acanyulaf/4SW-1KW-Buck-Boost/README.md

# 4SW-1KW-Buck-Boost
 1kW 28V 4 Switches Buck Boost Converter with 28V Fixed Output, Voltage Ripple<1% Inductor Current Ripple<30%
