acanyulaf/4SW-1KW-Buck-Boost/plots/frequency.png

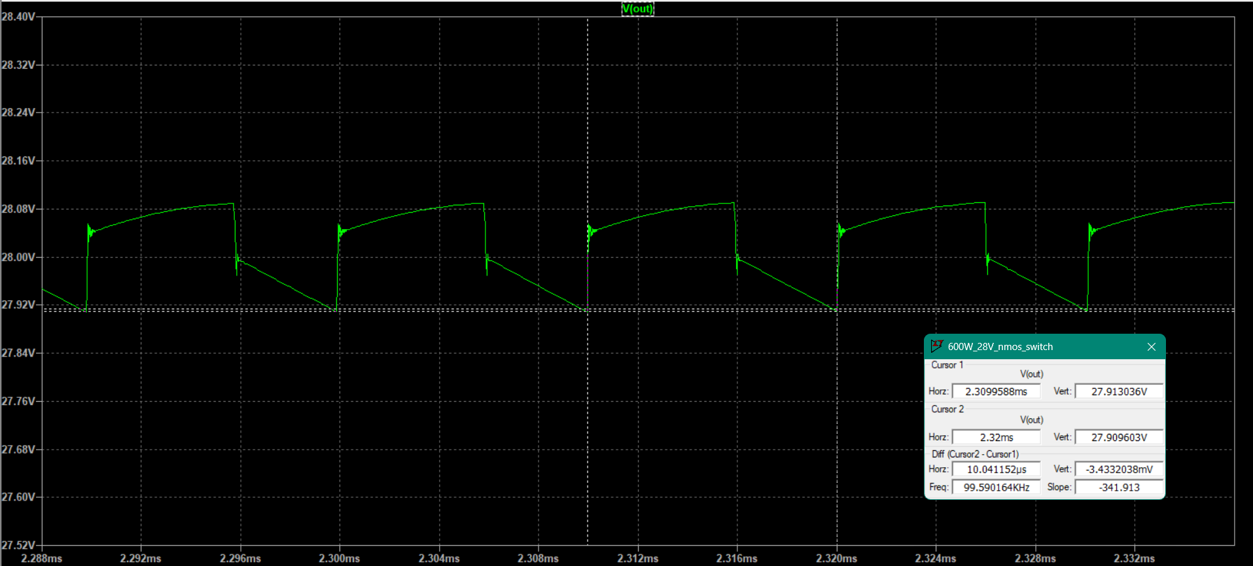
plots/frequency.png
