acanyulaf/4SW-1KW-Buck-Boost/plots/m1_m2_gate_to_source_signals.png

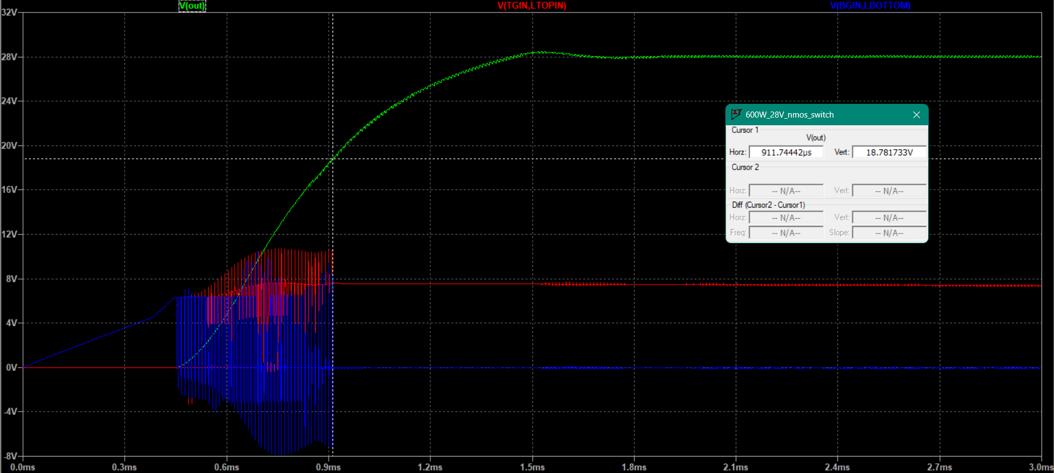
plots/m1_m2_gate_to_source_signals.png
