acanyulaf/4SW-1KW-Buck-Boost/plots/m3_m4_gate_to_source_signals.png

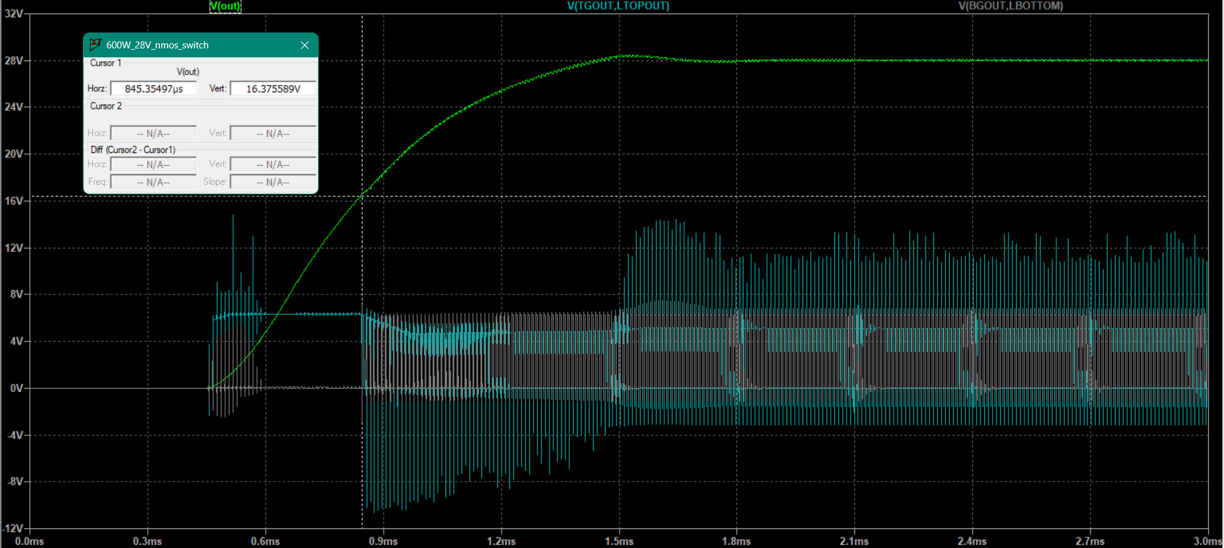
plots/m3_m4_gate_to_source_signals.png
