acanyulaf/4SW-1KW-Buck-Boost/plots/output_ripple_with_50PZJ220M10X15.png

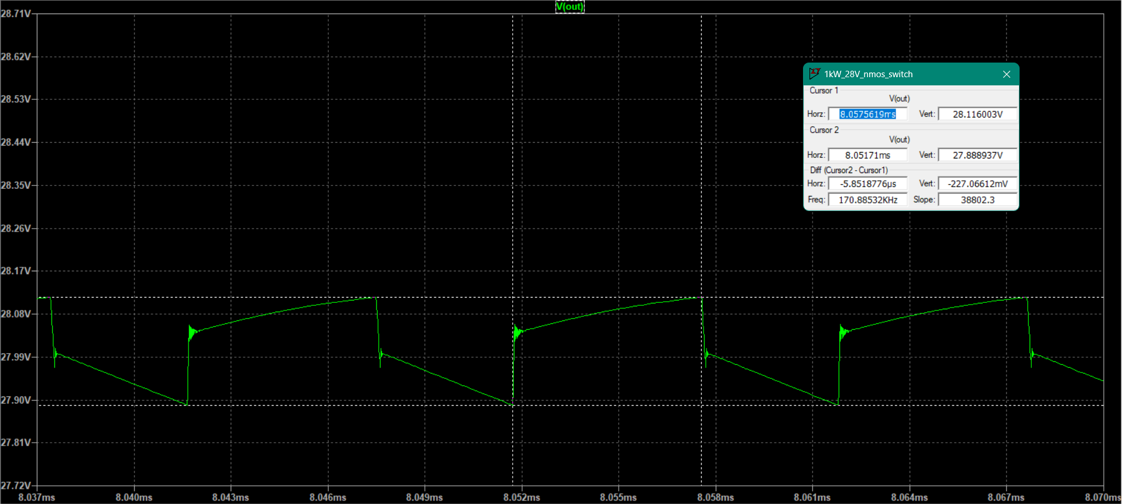
plots/output_ripple_with_50PZJ220M10X15.png
