acanyulaf/4SW-1KW-Buck-Boost/plots/StrongIRFET/full_load_@36_Vin.png

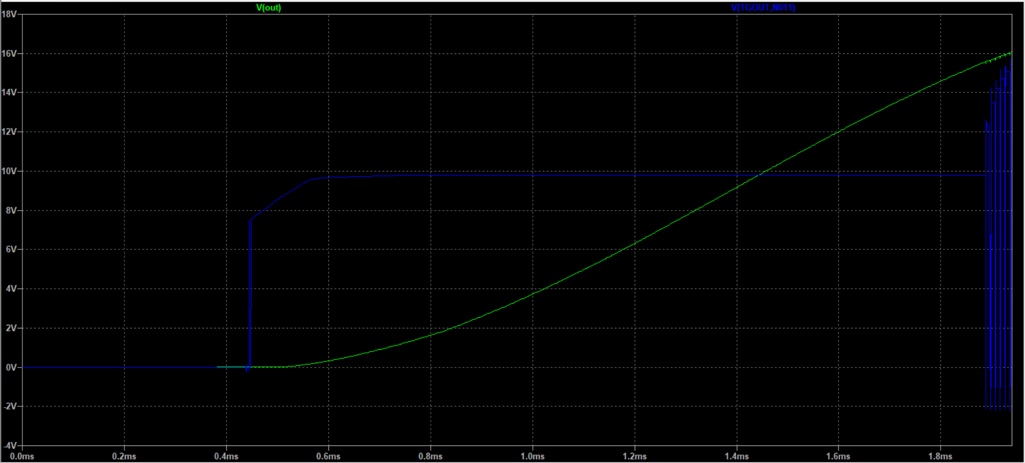
plots/StrongIRFET/full_load_@36_Vin.png
