acanyulaf/4SW-1KW-Buck-Boost/plots/StrongIRFET/IPTC044NM5M5R_gate_drive.png

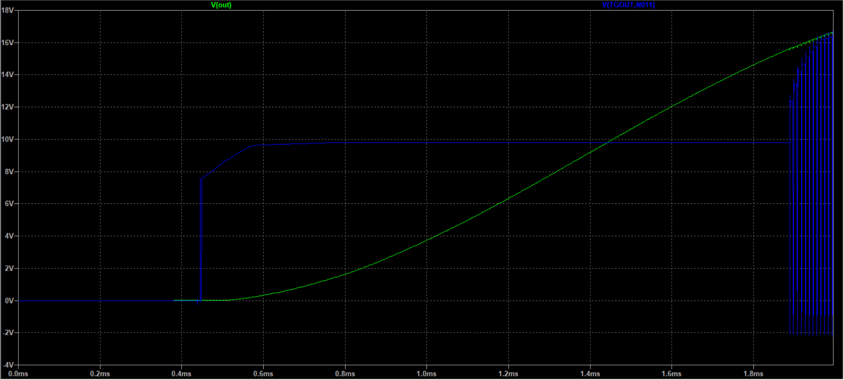
plots/StrongIRFET/IPTC044NM5M5R_gate_drive.png
