acanyulaf/4SW-1KW-Buck-Boost/plots/underdamped/Screenshot 2023-09-11 122802.png

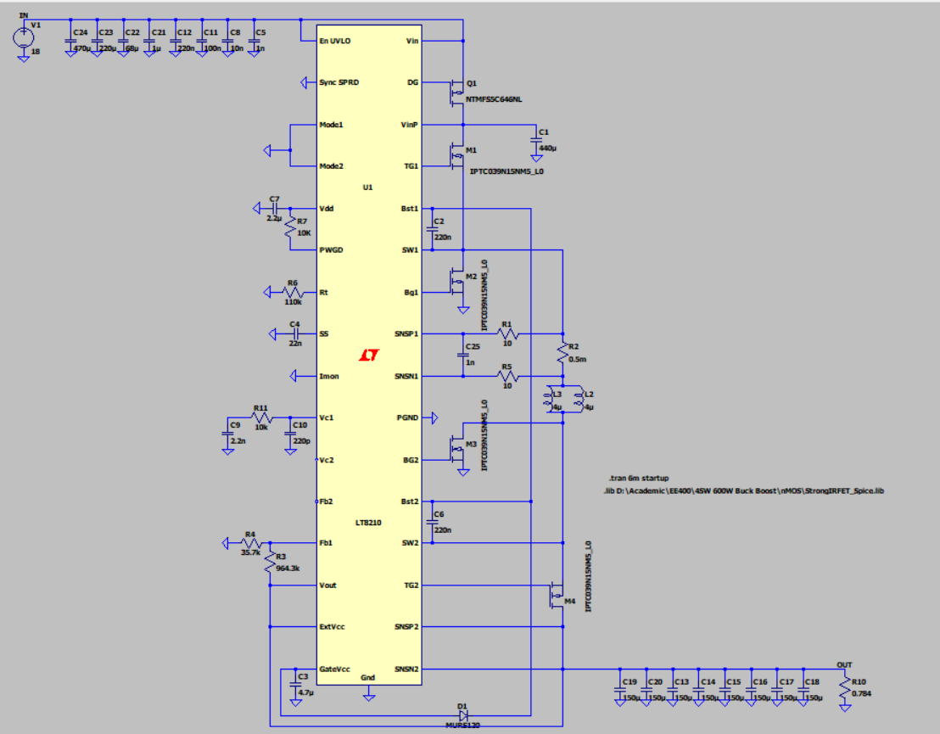
plots/underdamped/Screenshot 2023-09-11 122802.png
