acanyulaf/4SW-1KW-Buck-Boost/plots/underdamped/Vout_I_L_Waveforms.png

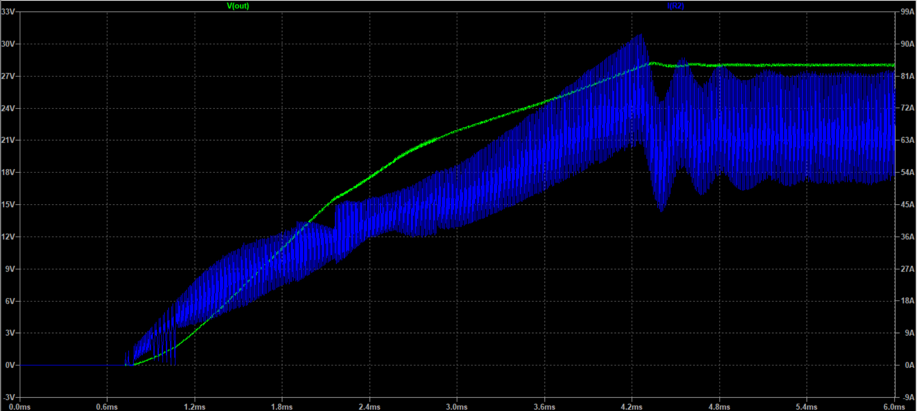
plots/underdamped/Vout_I_L_Waveforms.png
