acanyulaf/4SW-1KW-Buck-Boost/plots/Vout.png

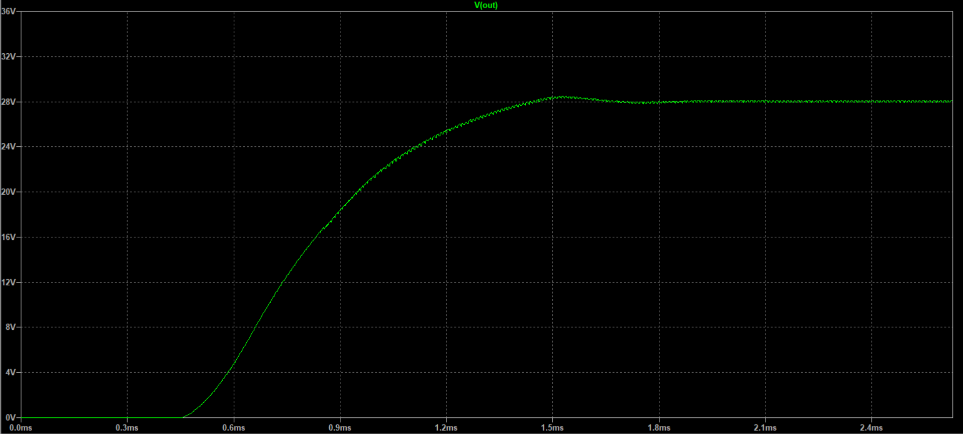
plots/Vout.png
