acanyulaf/4SW-1KW-Buck-Boost/plots/Vout_ripple.png

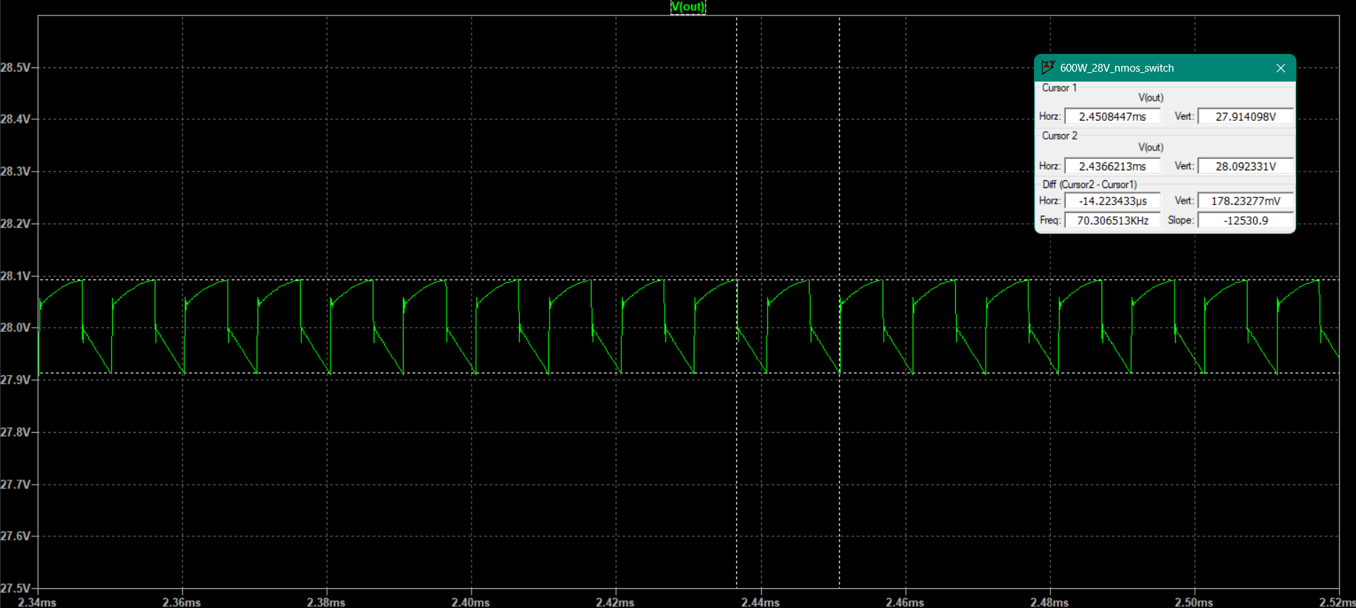
plots/Vout_ripple.png
