acanyulaf/4SW-1KW-Buck-Boost/plots/W_AOTL66518/burst/1_100_Load_@30Vin.png

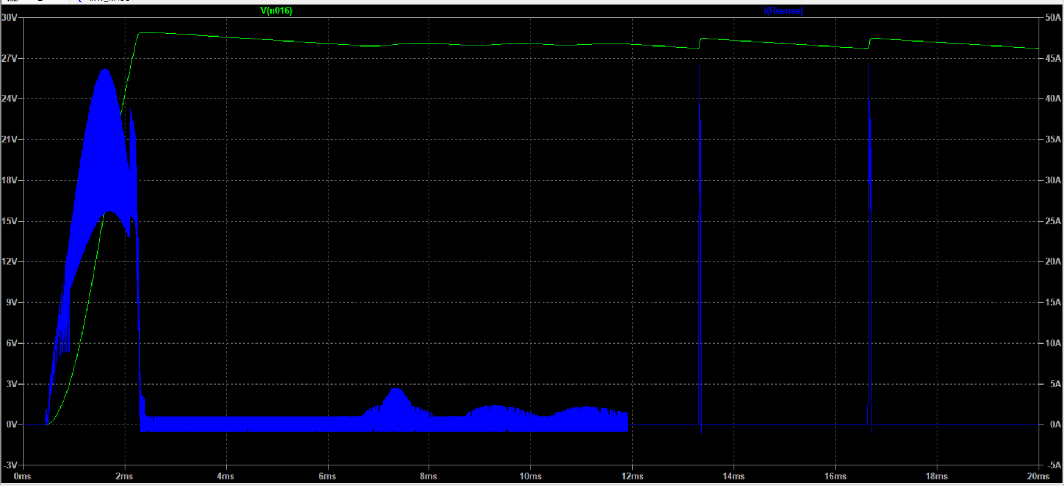
plots/W_AOTL66518/burst/1_100_Load_@30Vin.png
