acanyulaf/4SW-1KW-Buck-Boost/plots/W_AOTL66518/burst/1_1000_LOAD CONDİTİON_@18_Vin.png

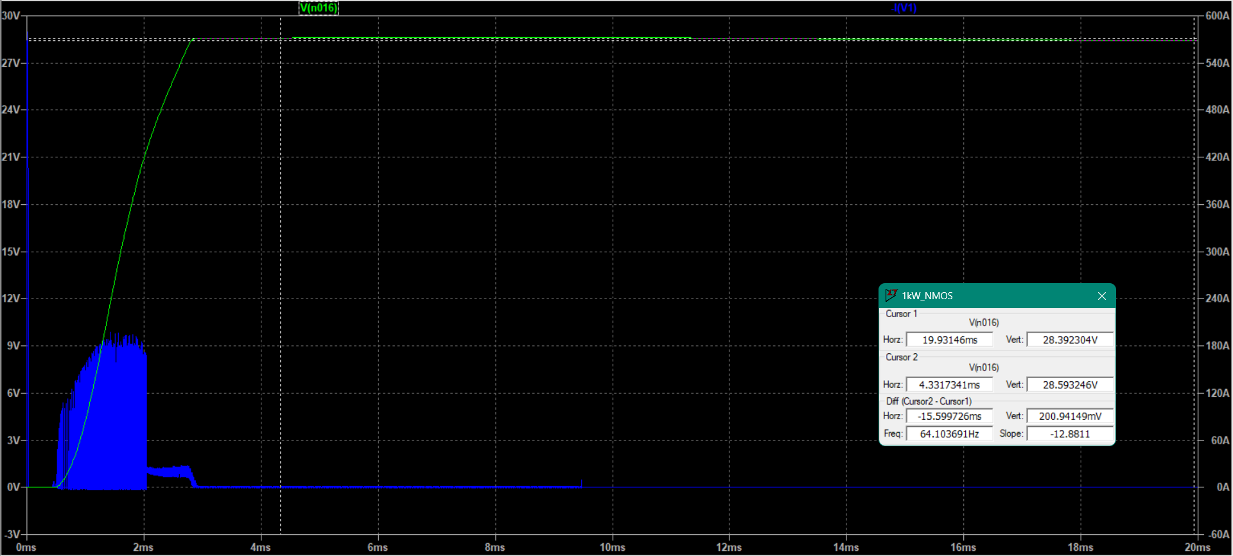
plots/W_AOTL66518/burst/1_1000_LOAD CONDİTİON_@18_Vin.png
