acanyulaf/4SW-1KW-Buck-Boost/plots/W_AOTL66518/burst/bottom_gate_signals.png

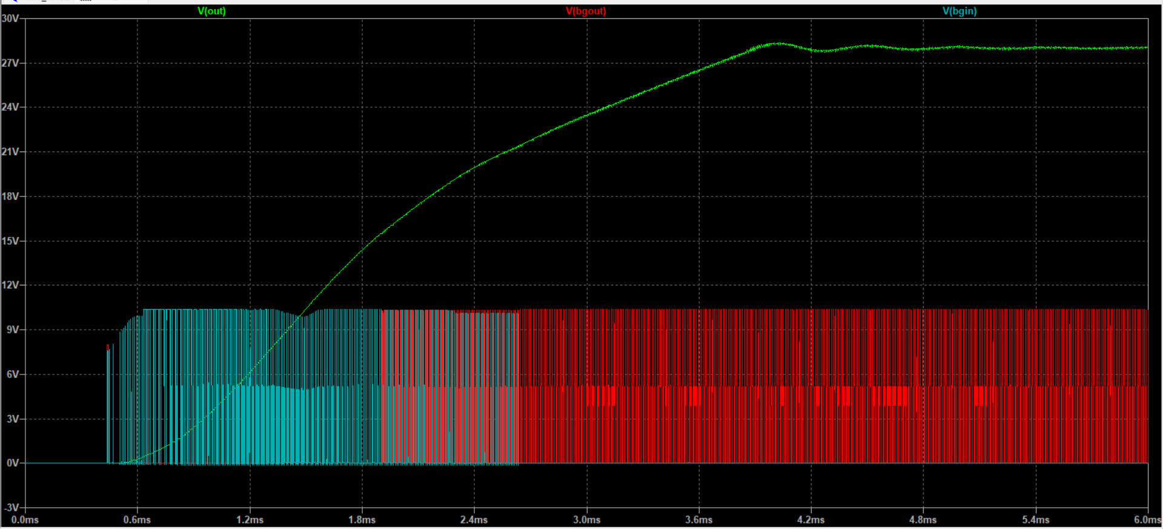
plots/W_AOTL66518/burst/bottom_gate_signals.png
