acanyulaf/4SW-1KW-Buck-Boost/plots/W_AOTL66518/burst/frequency.png

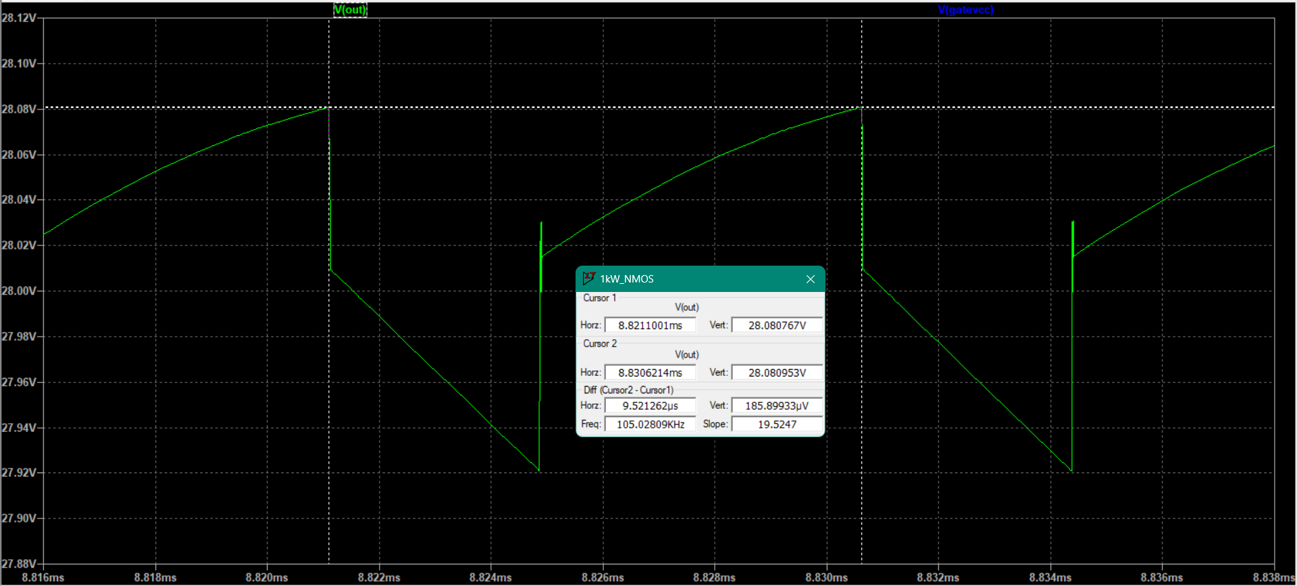
plots/W_AOTL66518/burst/frequency.png
