acanyulaf/4SW-1KW-Buck-Boost/plots/W_AOTL66518/burst/full_load_@30_Vin.png

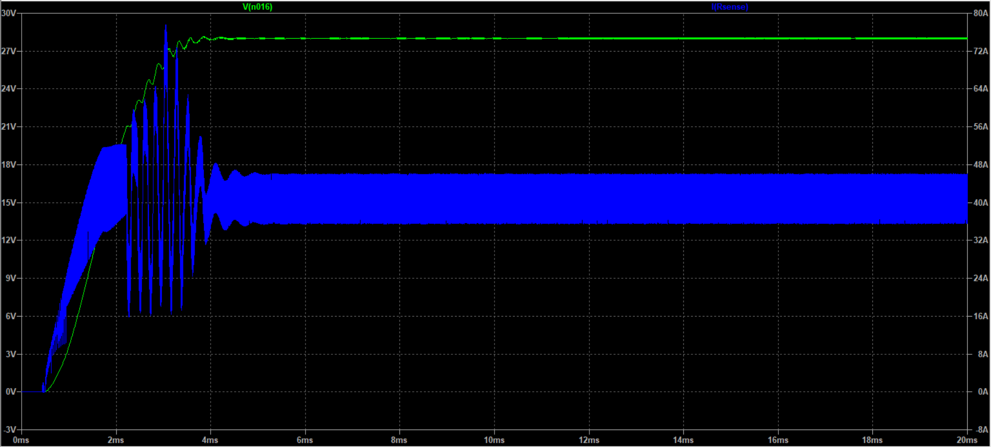
plots/W_AOTL66518/burst/full_load_@30_Vin.png
