acanyulaf/4SW-1KW-Buck-Boost/plots/W_AOTL66518/burst/Power_1_10_Load_@36_Vin.png

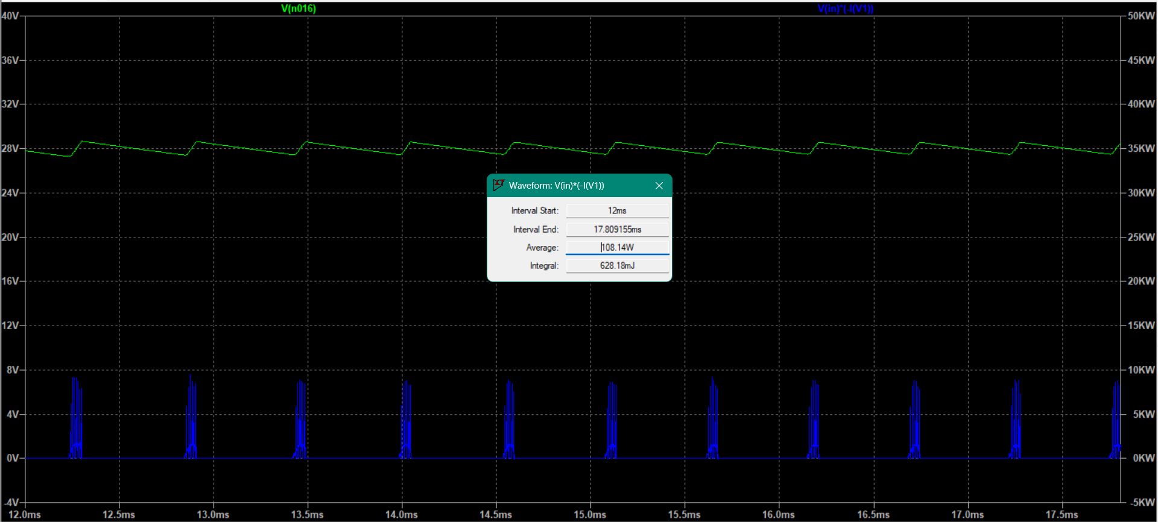
plots/W_AOTL66518/burst/Power_1_10_Load_@36_Vin.png
