acanyulaf/4SW-1KW-Buck-Boost/plots/W_AOTL66518/DCM/1_10_Load_@30_Vin.png

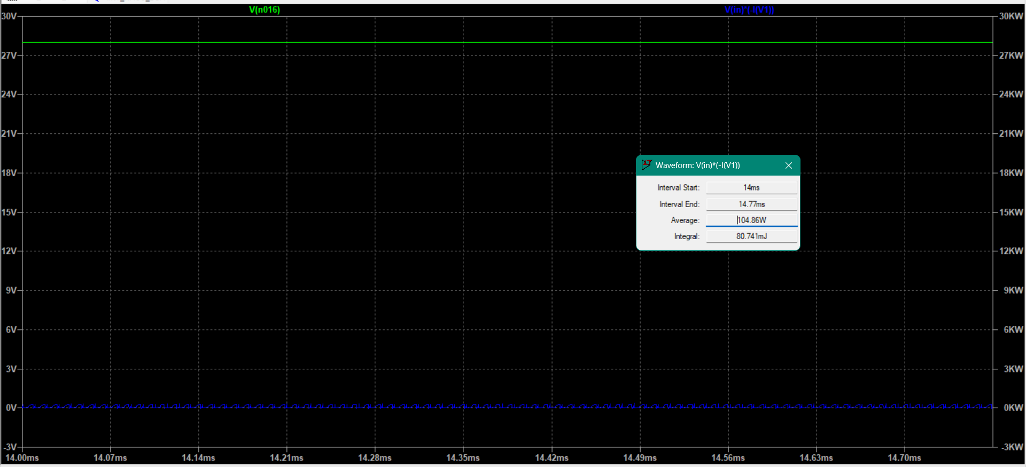
plots/W_AOTL66518/DCM/1_10_Load_@30_Vin.png
