acanyulaf/4SW-1KW-Buck-Boost/plots/W_AOTL66518/DCM/1_100_Load_@18_Vin.png

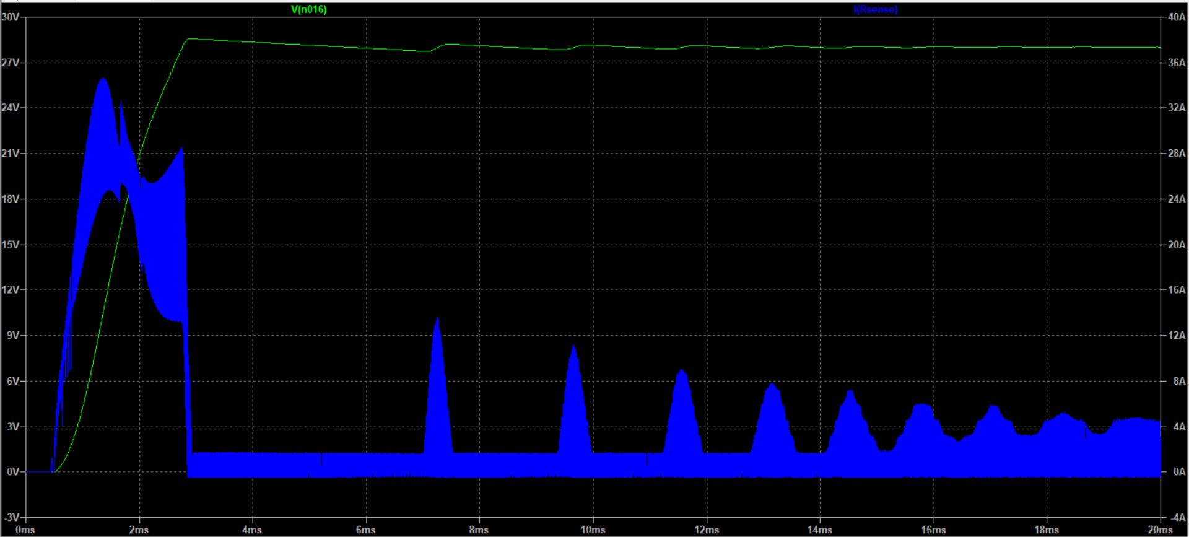
plots/W_AOTL66518/DCM/1_100_Load_@18_Vin.png
