acanyulaf/4SW-1KW-Buck-Boost/plots/W_AOTL66518/DCM/power_1_10_lOAD_@18_Vin.png

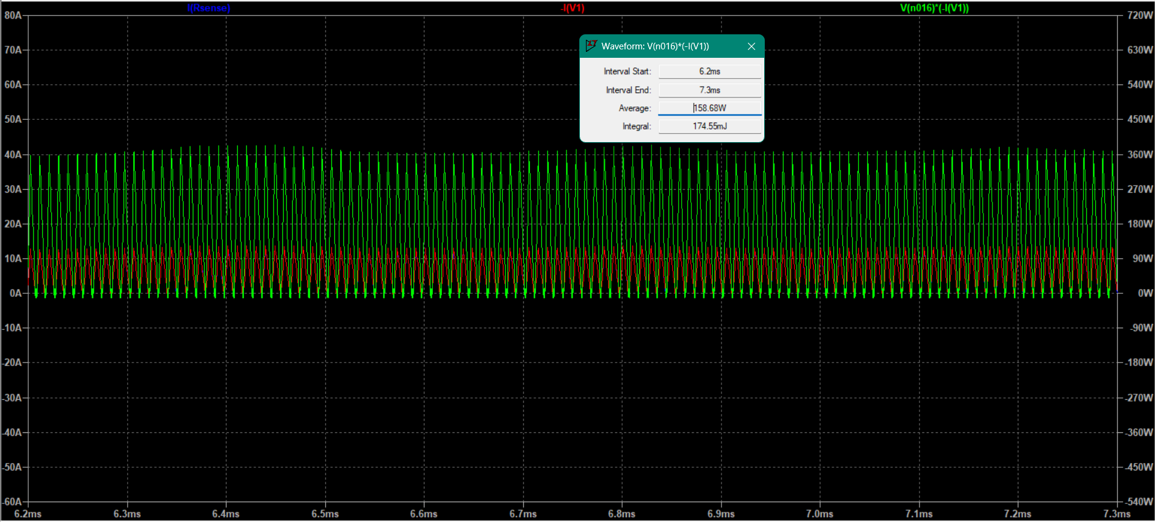
plots/W_AOTL66518/DCM/power_1_10_lOAD_@18_Vin.png
