acanyulaf/4SW-1KW-Buck-Boost/plots/W_AOTL66518/gate_drives_@ss.png

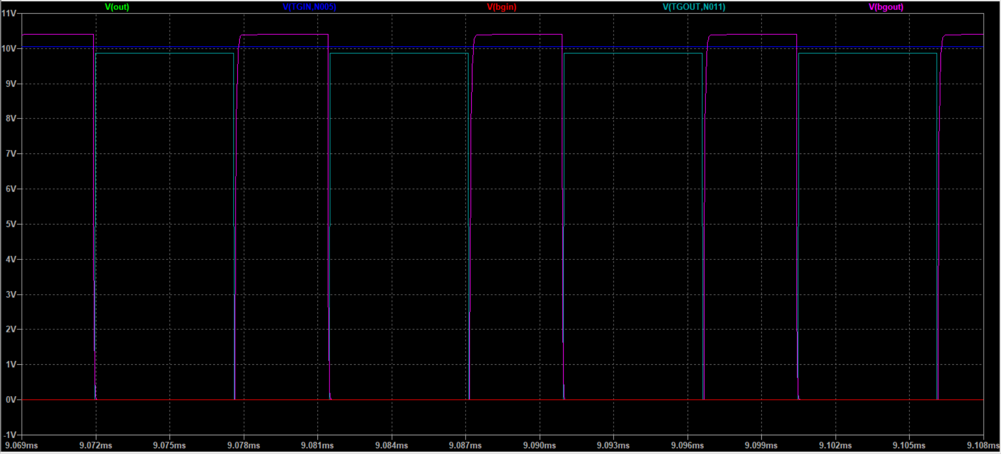
plots/W_AOTL66518/gate_drives_@ss.png
