acanyulaf/4SW-1KW-Buck-Boost/plots/W_AOTL66518/gate_vcc_waveform.png

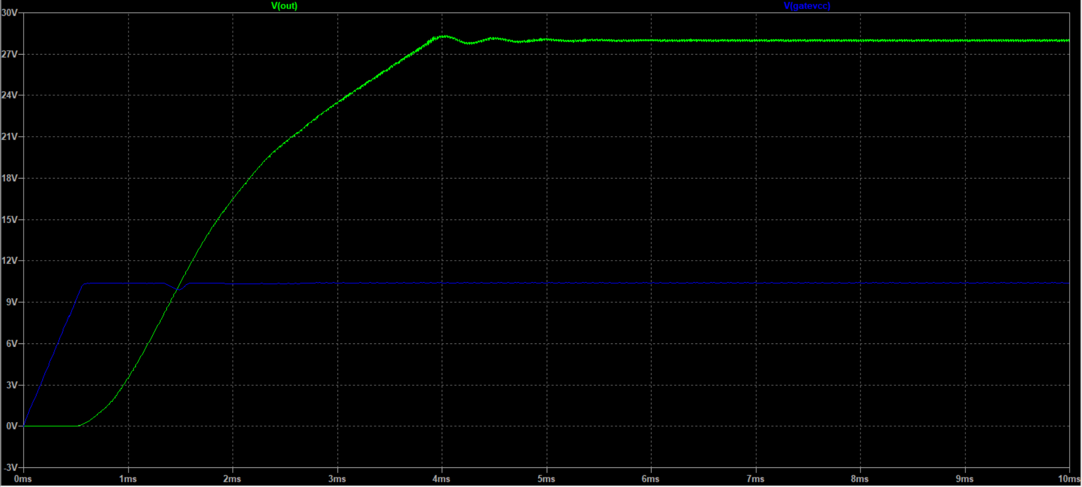
plots/W_AOTL66518/gate_vcc_waveform.png
