acanyulaf/4SW-1KW-Buck-Boost/plots/W_AOTL66518/inductor_current.png

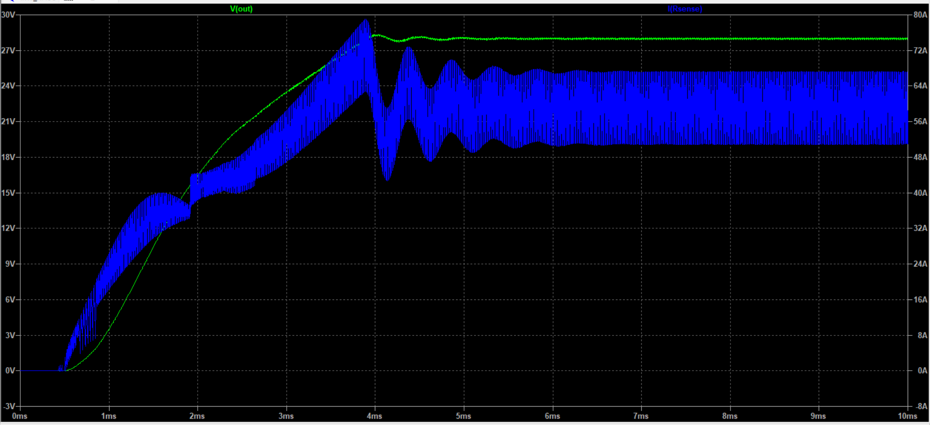
plots/W_AOTL66518/inductor_current.png
