acanyulaf/4SW-1KW-Buck-Boost/plots/W_AOTL66518/output_voltage_ripple.png

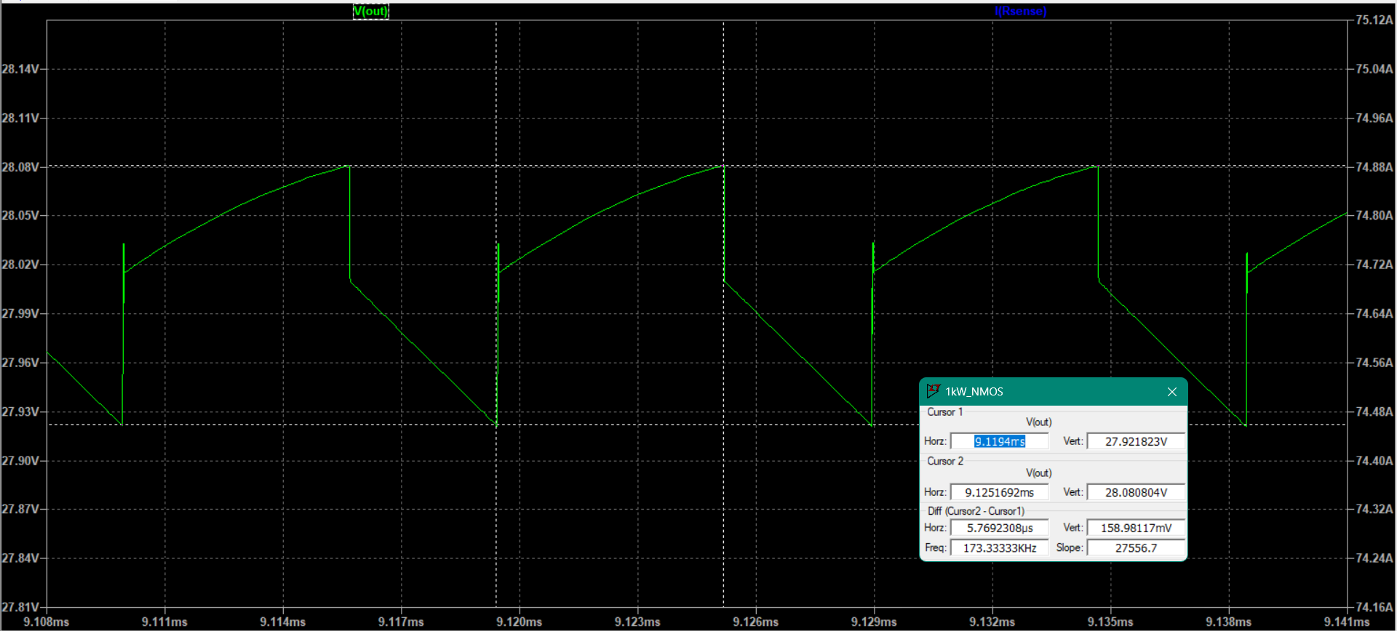
plots/W_AOTL66518/output_voltage_ripple.png
