acanyulaf/4SW-1KW-Buck-Boost/plots/W_AOTL66518/Screenshot 2023-09-13 075803.png

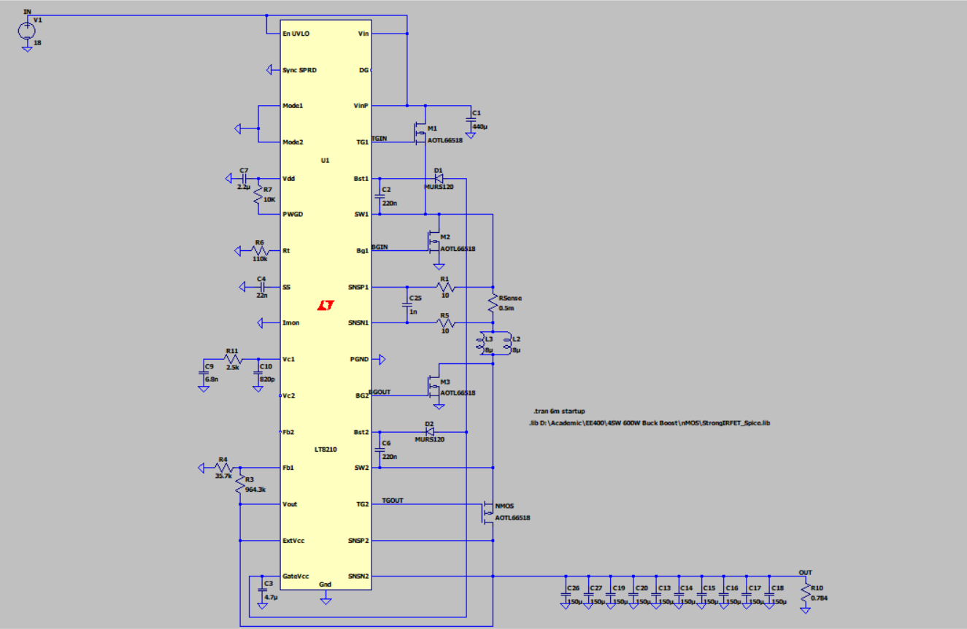
plots/W_AOTL66518/Screenshot 2023-09-13 075803.png
