acanyulaf/4SW-1KW-Buck-Boost/Schematic & PCB/kicad design files/EEH-AZS1H151B/EEH-AZS1H151B.step

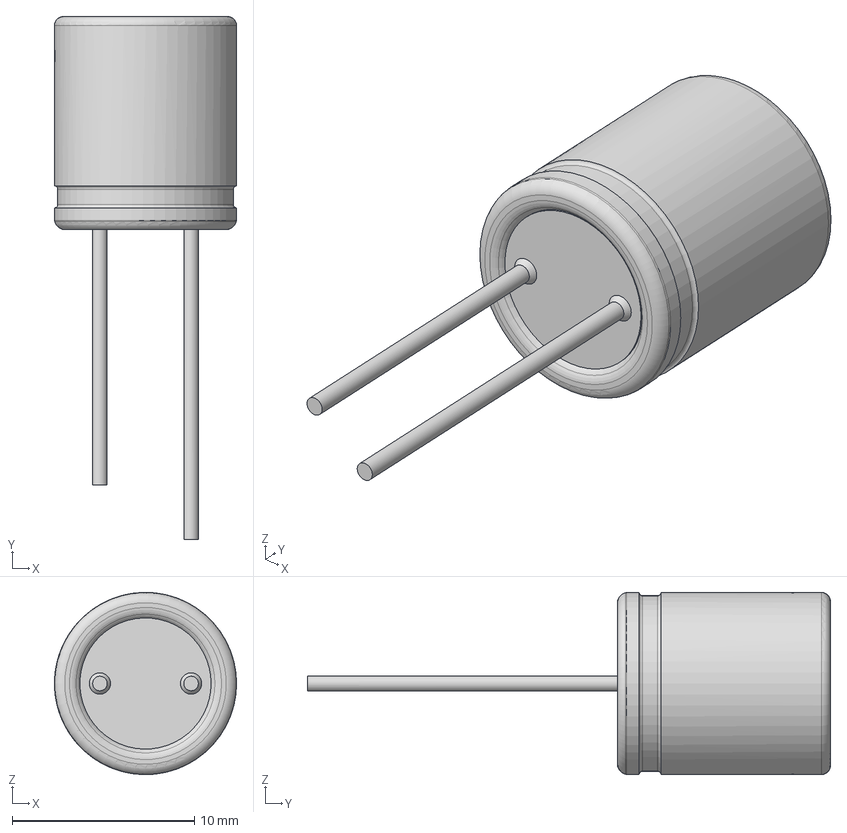
[picture p43: CAD file, 2023-09-29]
Schematic & PCB/kicad design files/EEH-AZS1H151B/EEH-AZS1H151B.step
10.0 x 28.7 x 10.0 mm
