acanyulaf/4SW-1KW-Buck-Boost/Schematic & PCB/kicad design files/IPTC019N10NM5ATMA1--3DModel-STEP-1.STEP

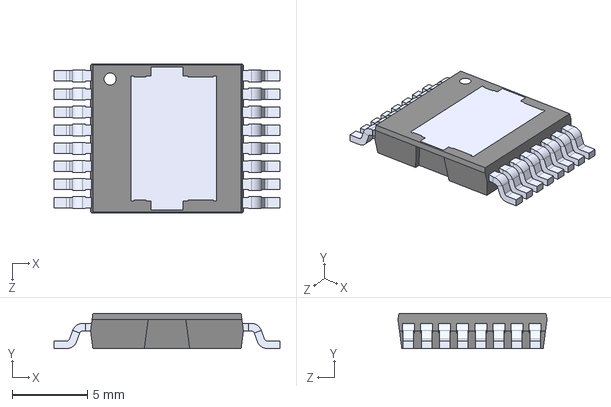
[picture p44: CAD file, 2023-09-29]
Schematic & PCB/kicad design files/IPTC019N10NM5ATMA1--3DModel-STEP-1.STEP
15.0 x 2.35 x 9.90 mm
