acanyulaf/4SW-1KW-Buck-Boost/Schematic & PCB/kicad design files/41_Pin._QFN.STEP

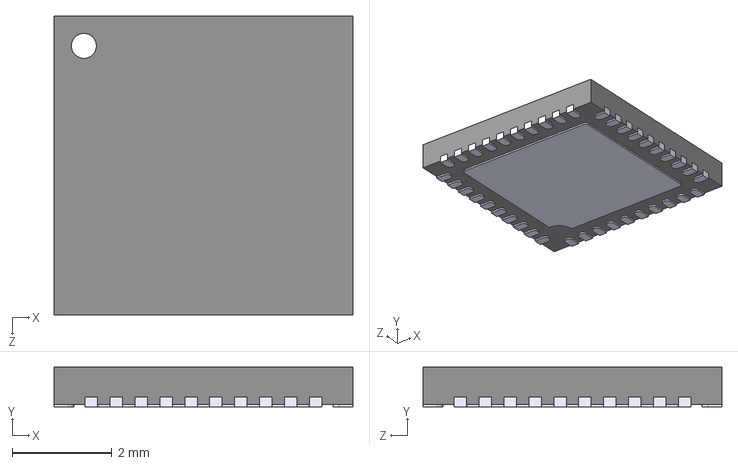
[picture p45: CAD file, 2023-09-29]
Schematic & PCB/kicad design files/41_Pin._QFN.STEP
6.00 x 0.8 x 6.00 mm
