acanyulaf/4SW-1KW-Buck-Boost/Schematic & PCB/kicad design files/IHLP8787MZ.STEP

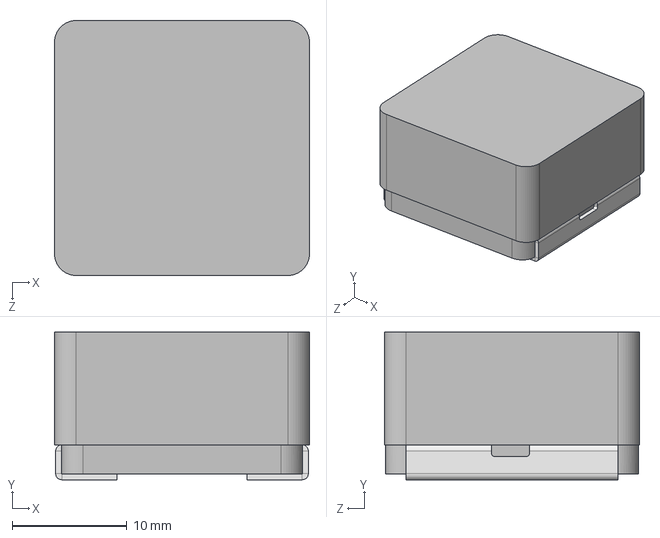
[picture p46: CAD file, 2023-09-29]
Schematic & PCB/kicad design files/IHLP8787MZ.STEP
22.3 x 12.9 x 22.3 mm
