acanyulaf/4SW-1KW-Buck-Boost/Schematic & PCB/kicad design files/7461094 (rev1).stp

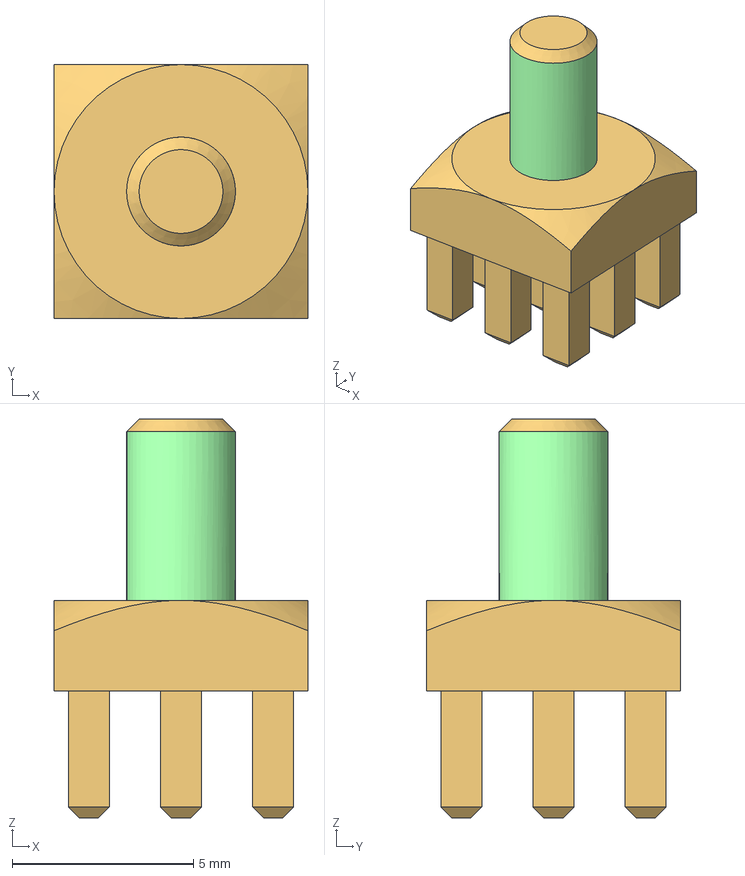
[picture p47: CAD file, 2023-09-29]
Schematic & PCB/kicad design files/7461094 (rev1).stp
7.00 x 7.00 x 11.0 mm
