acanyulaf/4SW-1KW-Buck-Boost/Schematic & PCB/kicad design files/7461096 (rev1).stp

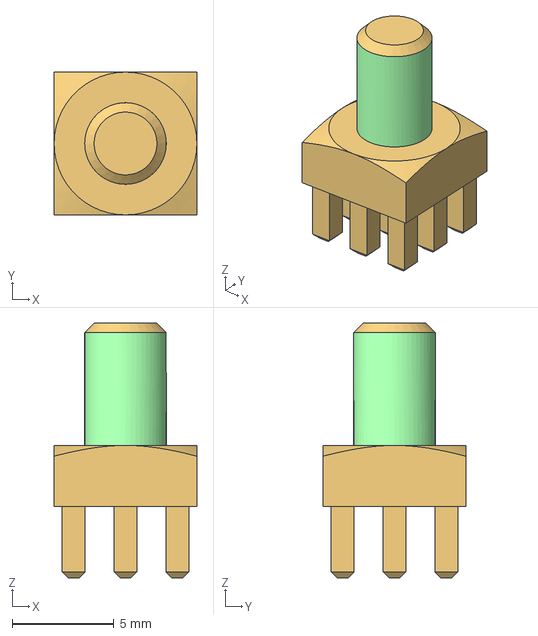
[picture p48: CAD file, 2023-09-29]
Schematic & PCB/kicad design files/7461096 (rev1).stp
7.00 x 7.00 x 12.5 mm
