acanyulaf/4SW-1KW-Buck-Boost/Schematic & PCB/kicad design files/74651195 (rev1).stp

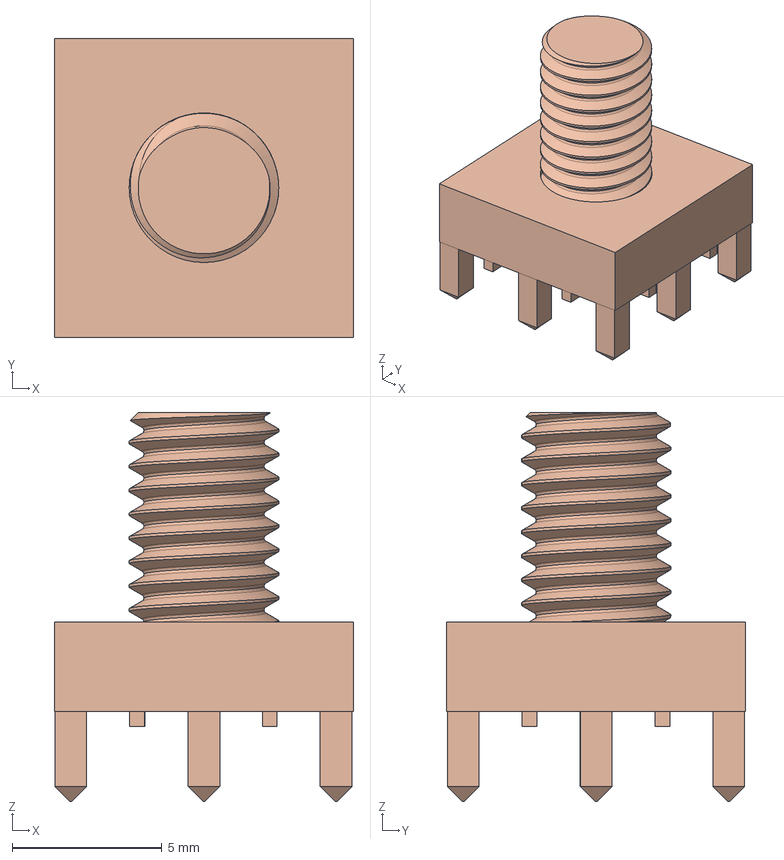
[picture p49: CAD file, 2023-09-29]
Schematic & PCB/kicad design files/74651195 (rev1).stp
10.0 x 10.0 x 13.0 mm
