acanyulaf/4SW-1KW-Buck-Boost/8210_test.asc

C1: cap; 440µ
C2: cap; 220n
C3: cap; 1µ
C4: cap; 2n
C5: cap; 960µ
C6: cap; 220n
C7: cap; 1µ
C8: cap; 15n
C9: cap; 6.8n
C10: cap; 820p
C11: cap; 2.2n
C12: cap; 220p
D1: diode; MURS120
D2: diode; MURS120
L1: ind; 4.7µ
Q1: nmos; NTMFS5C646NL
Q2: nmos; BSC032NE2LS
Q3: nmos; BSC032NE2LS
Q4: nmos; BSC032NE2LS
Q5: nmos; BSC032NE2LS
R1: res; 2m
R2: res; 2m
R3: res; 100K
R4: res; 14.3K
R5: res; 64.9K
R6: res; 46.4K
R7: res; 10K
R8: res; 100K
R9: res; 6.65K
R10: res; 2
R11: res; 2.61K
R12: res; 60.4K
U1: LT8210
V1: voltage; 12
Named nets: 0, OUT, IN
.tran 10m startup
