acanyulaf/4SW-1KW-Buck-Boost/1kW_28V_nmos_switch.asc

C1: cap; 1n
C2: cap; 4.7µ
C3: cap; 150µ; V=50 Irms=3.2 Rser=14m
C4: cap; 150µ; V=50 Irms=3.2 Rser=14m
C5: cap; 150µ; V=50 Irms=3.2 Rser=14m
C6: cap; 150µ; V=50 Irms=3.2 Rser=14m
C7: cap; 150µ; V=50 Irms=3.2 Rser=14m
C8: cap; 150µ; V=50 Irms=3.2 Rser=14m
C9: cap; 150µ; V=50 Irms=3.2 Rser=14m
C10: cap; 150µ; V=50 Irms=3.2 Rser=14m
C11: cap; 1n
C12: cap; 10n
C13: cap; 100n
C14: cap; 220n
C15: cap; 1µ
C16: cap; 1n
C17: cap; 0.22µ
C18: cap; 0.22µ
C19: cap; 68µ
C20: cap; 220µ
C21: cap; 470µ
C23: cap; 3.3n
C24: cap; 220p
C25: cap; 100n
Cin: cap; 1µ
Cldo: cap; 1µ
D5: diode; MURS120
D6: diode; MURS120
L1: ind; 8µ; Ipk=45 Rser=4.04m
L2: ind; 8µ; Ipk=45 Rser=4.04m
M1: nmos; IPTC039N15NM5_L0
M2: nmos; IPTC039N15NM5_L0
M3: nmos; IPTC039N15NM5_L0
M4: nmos; IPTC039N15NM5_L0
R1: res; 2
R2: res; 0.784
R14: res; 2
R20: res; 2
R21: res; 2
R22: res; 1m
R23: res; 10
R24: res; 10
R25: res; 100K
R26: res; 100K
R27: res; 100K
R28: res; 100K
R29: res; 957k
R30: res; 43k
R31: res; 4
R32: res; 100K
R33: res; 300k
R34: res; 150k
R36: res; 17.7k
Rt: res; 436.15k
U1: LT8705A
V8: voltage; 18
Named nets: 0, OUT, IN, LTOPIN, LTOPOUT, LBOTTOM, TGIN, BGIN, BGOUT, TGOUT
.tran 10m startup
.lib D:\\Academic\\EE400\\4SW 600W Buck Boost\
MOS\\StrongIRFET_Spice.lib
