acanyulaf/4SW-1KW-Buck-Boost/1kW_IPTC.asc

C1: cap; 4.7µ
C2: cap; 220n
C3: cap; 4.7µ
C4: cap; 22n
C5: cap; 760p
C6: cap; 220n
C7: cap; 4.7µ
C8: cap; 150µ; V=50 Irms=3.2 Rser=14m
C9: cap; 6.8n
C10: cap; 820p
C11: cap; 150µ; V=50 Irms=3.2 Rser=14m
C12: cap; 150µ; V=50 Irms=3.2 Rser=14m
C13: cap; 150µ; V=50 Irms=3.2 Rser=14m
C14: cap; 150µ; V=50 Irms=3.2 Rser=14m
C15: cap; 150µ; V=50 Irms=3.2 Rser=14m
C16: cap; 150µ; V=50 Irms=3.2 Rser=14m
C17: cap; 150µ; V=50 Irms=3.2 Rser=14m
C18: cap; 150µ; V=50 Irms=3.2 Rser=14m
C19: cap; 150µ; V=50 Irms=3.2 Rser=14m
C20: cap; 150µ; V=50 Irms=3.2 Rser=14m
C21: cap; 150µ; V=50 Irms=3.2 Rser=14m
C22: cap; 4.7µ
C23: cap; 4.7µ
C24: cap; 4.7µ
C25: cap; 1n
C26: cap; 150µ; V=50 Irms=3.2 Rser=14m
C27: cap; 150µ; V=50 Irms=3.2 Rser=14m
C28: cap; 1µ
C29: cap; 4.7µ
C30: cap; 4.7µ
C31: cap; 4.7µ
C32: cap; 4.7µ
D1: diode; MURS120
D2: diode; MURS120
L2: ind; 8µ; Ipk=45 Rser=4.04m
L3: ind; 8µ; Ipk=45 Rser=4.04m
M1: nmos; IPTC039N15NM5_L0
M2: nmos; IPTC039N15NM5_L0
M3: nmos; IPTC039N15NM5_L0
M4: nmos; IPTC039N15NM5_L0
R1: res; 10
R2: res; 21k
R3: res; 964.3k
R4: res; 35.7k
R5: res; 10
R6: res; 110k
R7: res; 10K
R8: res; 2m
R9: res; 80
R10: res; 0.784
R11: res; 2.5k
R12: res; 80
RSense: res; 0.5m
U1: LT8210
V1: voltage; 18
Named nets: 0, OUT, IN, TGIN, BGIN, BGOUT, TGOUT, Sense
.tran 10m startup
.lib D:\\Academic\\EE400\\4SW 600W Buck Boost\
MOS\\StrongIRFET_Spice.lib
