acanyulaf/4SW-1KW-Buck-Boost/1kW_NMOS_BURST.asc

C1: cap; 22µ
C2: cap; 220n
C3: cap; 4.7µ
C4: cap; 22n
C5: cap; 760p
C6: cap; 220n
C7: cap; 2.2µ
C8: cap; 1µ
C9: cap; 6.8n
C10: cap; 820p
C11: cap; 22µ
C13: cap; 150µ; V=50 Irms=3.2 Rser=14m
C14: cap; 150µ; V=50 Irms=3.2 Rser=14m
C15: cap; 150µ; V=50 Irms=3.2 Rser=14m
C16: cap; 150µ; V=50 Irms=3.2 Rser=14m
C17: cap; 150µ; V=50 Irms=3.2 Rser=14m
C18: cap; 150µ; V=50 Irms=3.2 Rser=14m
C19: cap; 150µ; V=50 Irms=3.2 Rser=14m
C20: cap; 150µ; V=50 Irms=3.2 Rser=14m
C23: cap; 150µ; V=50 Irms=3.2 Rser=14m
C24: cap; 150µ; V=50 Irms=3.2 Rser=14m
C25: cap; 1n
C26: cap; 150µ; V=50 Irms=3.2 Rser=14m
C27: cap; 150µ; V=50 Irms=3.2 Rser=14m
C28: cap; 150µ; V=50 Irms=3.2 Rser=14m
C29: cap; 150µ; V=50 Irms=3.2 Rser=14m
C35: cap; 22µ
C36: cap; 22µ
D1: diode; MURS120
D2: diode; MURS120
L2: ind; 8µ; Ipk=45 Rser=4.04m
L3: ind; 8µ; Ipk=45 Rser=4.04m
M1: nmos; AOTL66518
M2: nmos; AOTL66518
M3: nmos; AOTL66518
M4: nmos; AOTL66518
R1: res; 10
R2: res; 2m
R3: res; 964.3k
R4: res; 35.7k
R5: res; 10
R6: res; 110k
R7: res; 10K
R8: res; 21k
R9: res; 80
R10: res; 0.784
R11: res; 2.5k
R12: res; 80
RSense: res; 0.5m
U1: LT8210
V1: voltage; 18
Named nets: 0, IN, TGIN, BGIN, BGOUT, TGOUT, GateVcc, Sense
.tran 20m startup
.lib D:\\Academic\\EE400\\4SW 1KW Buck Boost\\StrongIRFET_Spice.lib
Current Limit: 40A
