acanyulaf/4SW-1KW-Buck-Boost/Schematic & PCB/Buck_Boost_4_SW_1KW/Buck_Boost_4_SW_1KW.kicad_pcb

## KiCad design Schematic & PCB/Buck_Boost_4_SW_1KW/Buck_Boost_4_SW_1KW.kicad_pcb (2023-09-29)

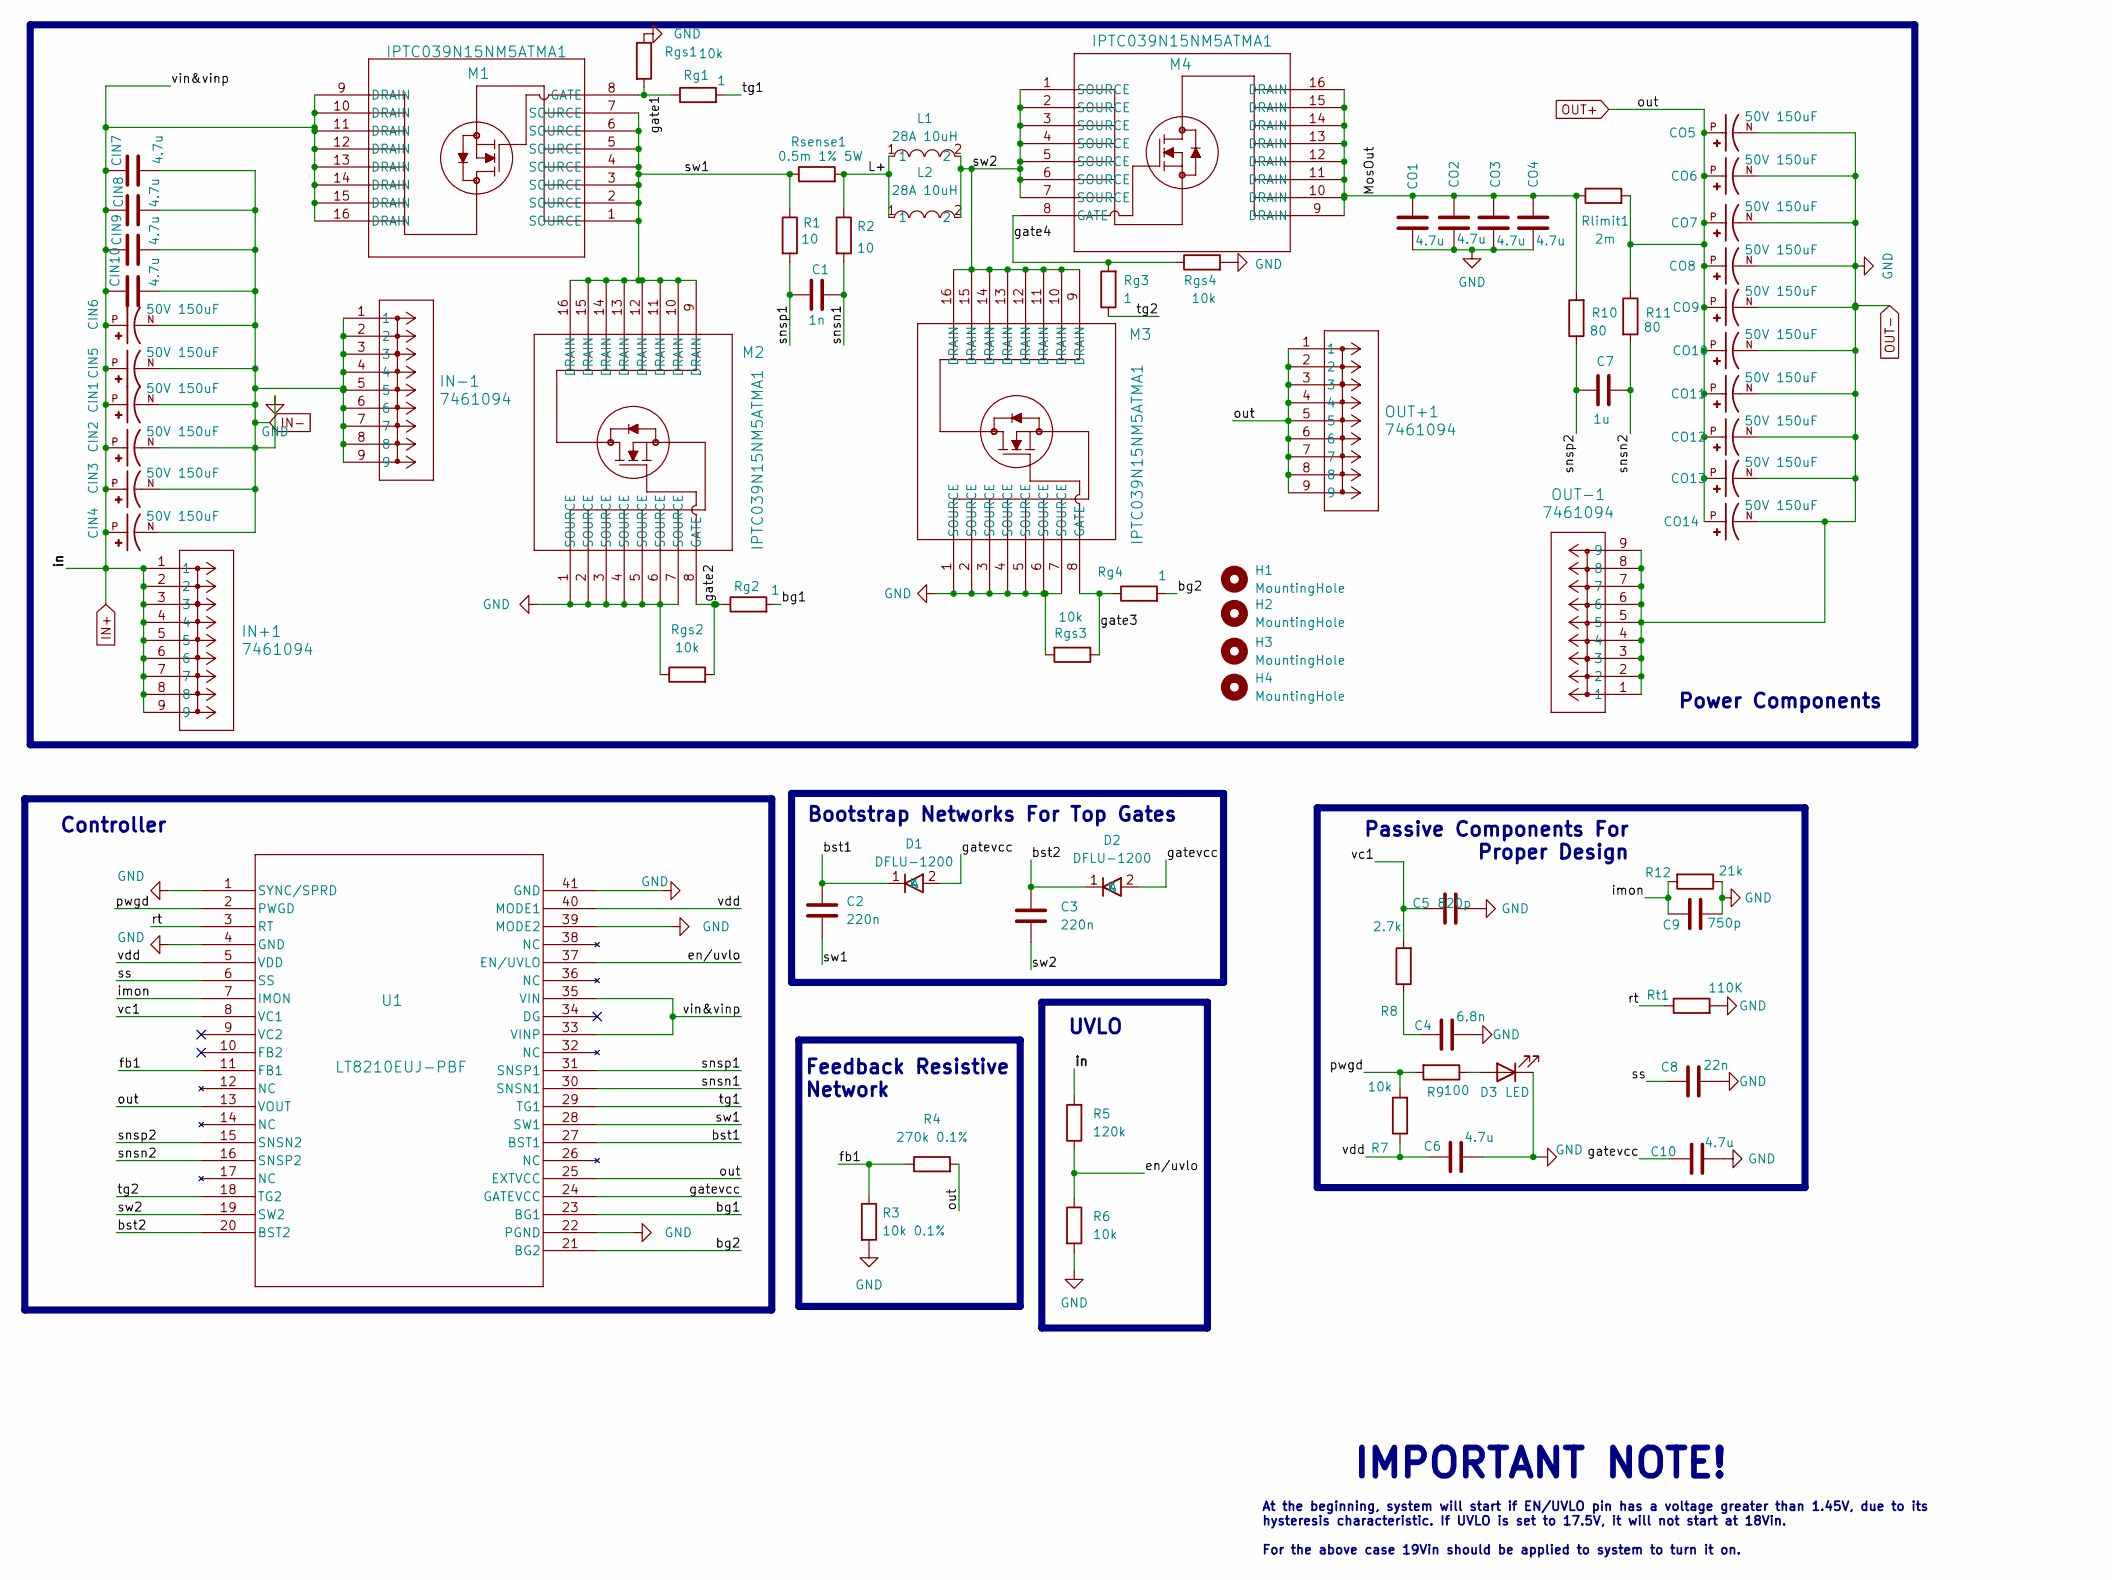
[picture p50: schematic Buck_Boost_4_SW_1KW.kicad_sch]

Parts:
C1: 1n; C_0603_1608Metric
C2, C3: 220n; C_0603_1608Metric
C4: 6.8n; C_0603_1608Metric
C5: 820p; C_0603_1608Metric
C6, C10: 4.7u; C_0805_2012Metric
C7: 1u; C_0603_1608Metric
C8: 22n; C_0603_1608Metric
C9: 750p; C_0603_1608Metric
CIN1, CIN2, CIN3, CIN4, CIN5, CIN6: 50V 150uF; EEH-AZS1H151B; PARTREV 30-SEP-20
CIN7, CIN8, CIN9, CIN10: 4.7u; C_0805_2012Metric
CO1, CO2, CO3, CO4: 4.7u; C_0805_2012Metric
CO5, CO6, CO7, CO8, CO9, CO10, CO11, CO12, CO13, CO14: 50V 150uF; EEH-AZS1H151B; PARTREV 30-SEP-20
D1, D2: DFLU-1200; D_PowerDI-123
D3: LED; LED_0603_1608Metric
H1, H2, H3, H4: MountingHole; MountingHole_3mm
IN+1: 7461094; Würth RedCube Terminals-7461094
IN-1: 7461094; Würth RedCube Terminals-7461094
L1, L2: 28A 10uH; IHLP8787MZER100M51
M1, M2, M3, M4: IPTC039N15NM5ATMA1; PG-HDSOP-16-2
OUT+1: 7461094; Würth RedCube Terminals-7461094
OUT-1: 7461094; Würth RedCube Terminals-7461094
R1, R2: 10; R_0603_1608Metric
R3: 10k 0.1%; R_0603_1608Metric
R4: 270k 0.1%; R_0603_1608Metric
R5: 120k; R_0603_1608Metric
R6, R7: 10k; R_0603_1608Metric
R8: 2.7k; R_0603_1608Metric
R9: 100; R_0603_1608Metric
R10, R11: 80; R_0603_1608Metric
R12: 21k; R_0603_1608Metric
Rg1, Rg2, Rg3, Rg4: 1; R_1206_3216Metric
Rgs1, Rgs2, Rgs3, Rgs4: 10k; R_0603_1608Metric
Rlimit1: 2m; R_2512_6332Metric
Rsense1: 0.5m 1% 5W; R_2512_6332Metric
Rt1: 110K; R_0603_1608Metric
U1: LT8210EUJ-PBF; PQFN40_UJ_ADI

Connections:
/L+: L1.1, L2.1, R2.1, Rsense1.2
/MosOut: CO1.1, CO2.1, CO3.1, CO4.1, M4.9 (DRAIN), M4.10 (DRAIN), M4.11 (DRAIN), M4.12 (DRAIN), M4.13 (DRAIN), M4.14 (DRAIN), M4.15 (DRAIN), M4.16 (DRAIN), R10.2, Rlimit1.1
/bg1: Rg2.2, U1.23 (BG1)
/bg2: Rg4.2, U1.21 (BG2)
/bst1: C2.1, D1.1 (K), U1.27 (BST1)
/bst2: C3.1, D2.1 (K), U1.20 (BST2)
/en/uvlo: R5.1, R6.1, U1.37 (EN/UVLO)
/fb1: R3.1, R4.1, U1.11 (FB1)
/gate1: M1.8 (GATE), Rg1.1, Rgs1.2
/gate2: M2.8 (GATE), Rg2.1, Rgs2.2
/gate3: M3.8 (GATE), Rg4.1, Rgs3.1
/gate4: M4.8 (GATE), Rg3.2, Rgs4.1
/gatevcc: C10.1, D1.2 (A), D2.2 (A), U1.24 (GATEVCC)
/imon: C9.1, R12.2, U1.7 (IMON)
/pwgd: R7.2, R9.2, U1.2 (PWGD)
/rt: Rt1.1, U1.3 (RT)
/snsn1: C1.2, R2.2, U1.30 (SNSN1)
/snsn2: C7.2, R11.2, U1.16 (SNSP2)
/snsp1: C1.1, R1.2, U1.31 (SNSP1)
/snsp2: C7.1, R10.1, U1.15 (SNSN2)
/ss: C8.1, U1.6 (SS)
/sw1: C2.2, M1.1 (SOURCE), M1.2 (SOURCE), M1.3 (SOURCE), M1.4 (SOURCE), M1.5 (SOURCE), M1.6 (SOURCE), M1.7 (SOURCE), M2.9 (DRAIN), M2.10 (DRAIN), M2.11 (DRAIN), M2.12 (DRAIN), M2.13 (DRAIN), M2.14 (DRAIN), M2.15 (DRAIN), M2.16 (DRAIN), R1.1, Rsense1.1, U1.28 (SW1)
/sw2: C3.2, L1.2, L2.2, M3.9 (DRAIN), M3.10 (DRAIN), M3.11 (DRAIN), M3.12 (DRAIN), M3.13 (DRAIN), M3.14 (DRAIN), M3.15 (DRAIN), M3.16 (DRAIN), M4.1 (SOURCE), M4.2 (SOURCE), M4.3 (SOURCE), M4.4 (SOURCE), M4.5 (SOURCE), M4.6 (SOURCE), M4.7 (SOURCE), U1.19 (SW2)
/tg1: Rg1.2, U1.29 (TG1)
/tg2: Rg3.1, U1.18 (TG2)
/vc1: C5.1, R8.2, U1.8 (VC1)
/vdd: C6.2, R7.1, U1.5 (VDD), U1.40 (MODE1)
IN+: CIN1.P, CIN2.P, CIN3.P, CIN4.P, CIN5.P, CIN6.P, CIN7.1, CIN8.1, CIN9.1, CIN10.1, IN+1.1, IN+1.2, IN+1.3, IN+1.4, IN+1.5, IN+1.6, IN+1.7, IN+1.8, IN+1.9, M1.9 (DRAIN), M1.10 (DRAIN), M1.11 (DRAIN), M1.12 (DRAIN), M1.13 (DRAIN), M1.14 (DRAIN), M1.15 (DRAIN), M1.16 (DRAIN), R5.2, U1.33 (VINP), U1.35 (VIN)
IN-: C4.2, C5.2, C6.1, C8.2, C9.2, C10.2, CIN1.N, CIN2.N, CIN3.N, CIN4.N, CIN5.N, CIN6.N, CIN7.2, CIN8.2, CIN9.2, CIN10.2, CO1.2, CO2.2, CO3.2, CO4.2, CO5.N, CO6.N, CO7.N, CO8.N, CO9.N, CO10.N, CO11.N, CO12.N, CO13.N, CO14.N, D3.1 (K), IN-1.1, IN-1.2, IN-1.3, IN-1.4, IN-1.5, IN-1.6, IN-1.7, IN-1.8, IN-1.9, M2.1 (SOURCE), M2.2 (SOURCE), M2.3 (SOURCE), M2.4 (SOURCE), M2.5 (SOURCE), M2.6 (SOURCE), M2.7 (SOURCE), M3.1 (SOURCE), M3.2 (SOURCE), M3.3 (SOURCE), M3.4 (SOURCE), M3.5 (SOURCE), M3.6 (SOURCE), M3.7 (SOURCE), OUT-1.1, OUT-1.2, OUT-1.3, OUT-1.4, OUT-1.5, OUT-1.6, OUT-1.7, OUT-1.8, OUT-1.9, R3.2, R6.2, R12.1, Rgs1.1, Rgs2.1, Rgs3.2, Rgs4.2, Rt1.2, U1.1 (SYNC/SPRD), U1.4 (GND), U1.22 (PGND), U1.39 (MODE2), U1.41 (GND)
unnamed: C4.1, R8.1
unnamed: D3.2 (A), R9.1
OUT+: CO5.P, CO6.P, CO7.P, CO8.P, CO9.P, CO10.P, CO11.P, CO12.P, CO13.P, CO14.P, OUT+1.1, OUT+1.2, OUT+1.3, OUT+1.4, OUT+1.5, OUT+1.6, OUT+1.7, OUT+1.8, OUT+1.9, R4.2, R11.1, Rlimit1.2, U1.13 (VOUT), U1.25 (EXTVCC)

Notes on the sheet:
Controller
Bootstrap Networks For Top Gates
UVLO
At the beginning, system will start if EN/UVLO pin has a voltage greater than 1.45V, due to its hysteresis characteristic. If UVLO is set to 17.5V, it will not start at 18Vin. For the above case 19Vin should be applied to system to turn it on.
Power Components
Passive Components For Proper Design
IMPORTANT NOTE!
Feedback Resistive Network

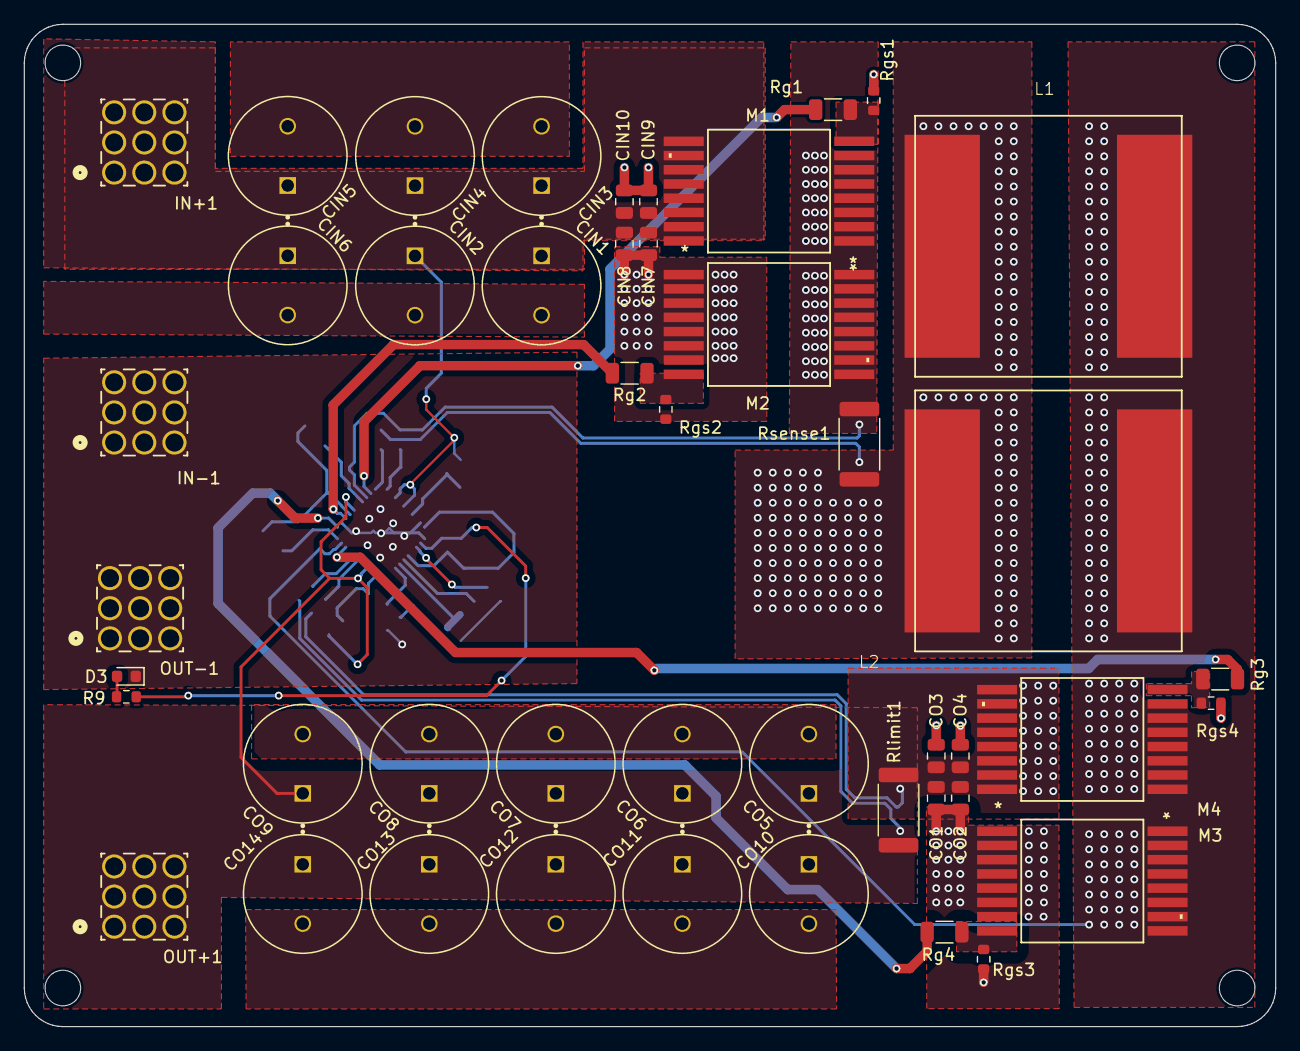
[picture p51: board Buck_Boost_4_SW_1KW.kicad_pcb from above]

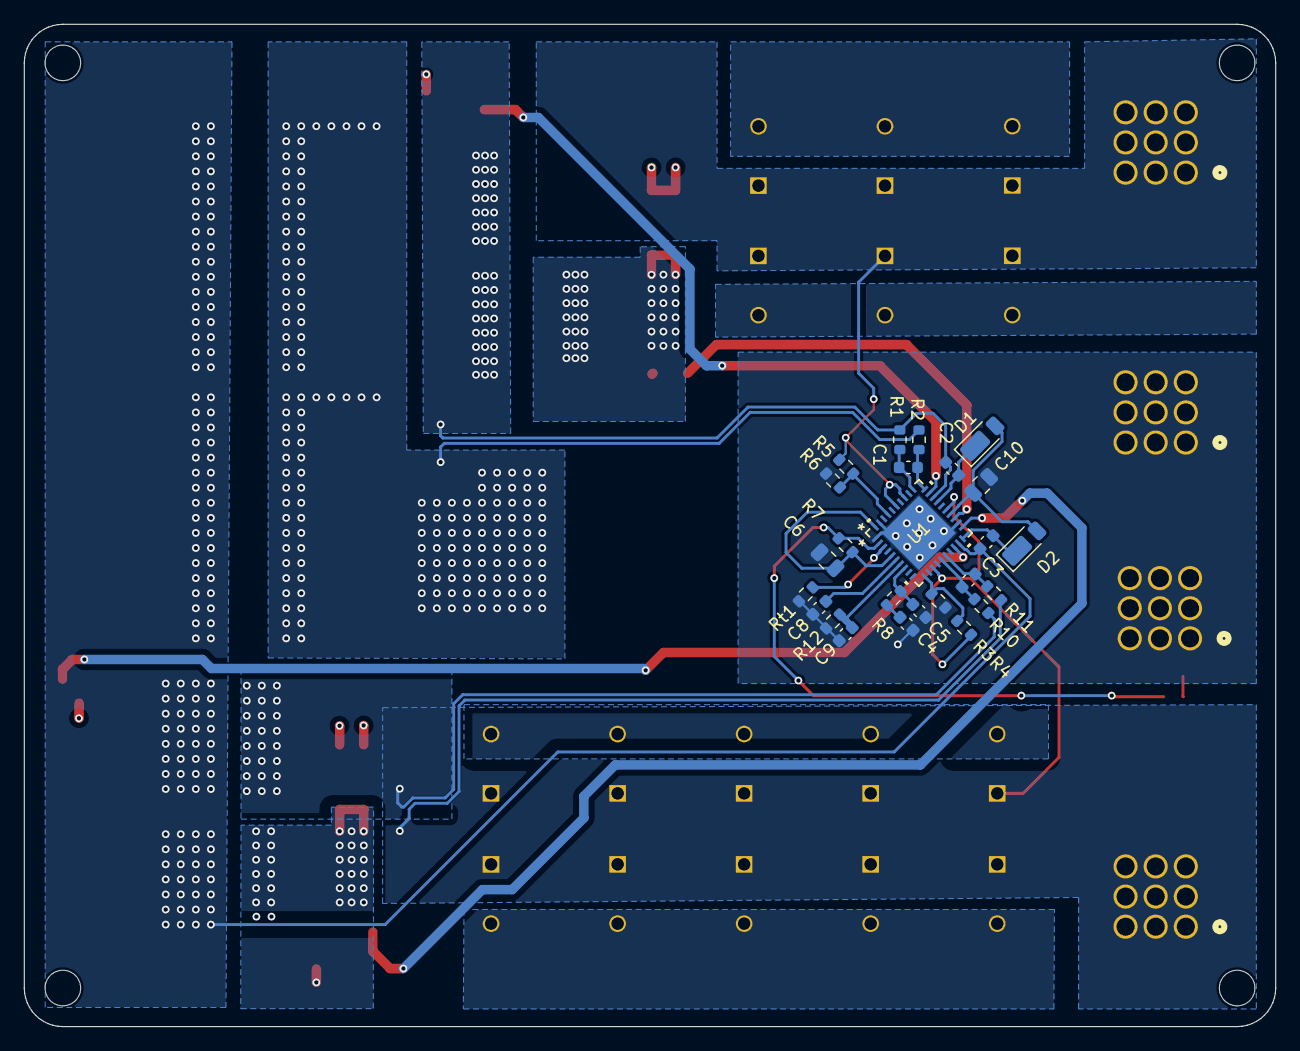
[picture p52: board Buck_Boost_4_SW_1KW.kicad_pcb from below]

Board: 4 copper layers, 105.5 x 84.5 mm, 75 parts (25 on the bottom side), 32 nets.
